izyaandev/HALFLIFE---PENDANTPCB/hardware/pcb/half-life-pendant-schematic.pdf

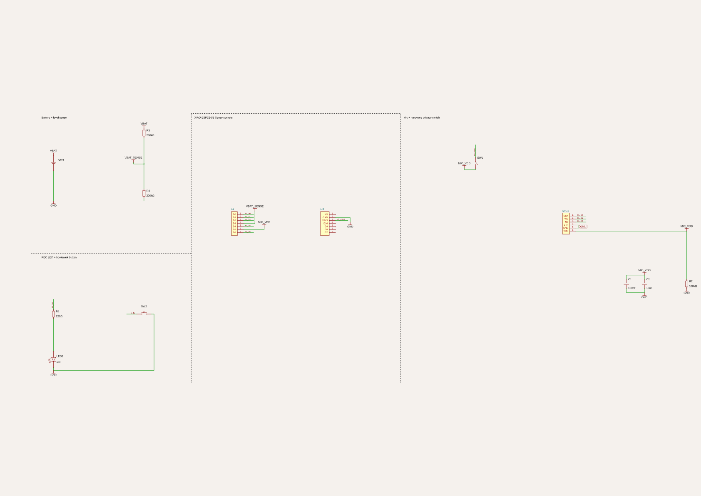
[picture p7: page 1]
