izyaandev/HALFLIFE---PENDANTPCB/hardware/bom.csv

Designator | Qty | Value | Description | PCB footprint | Placed on carrier PCB | Notes
U1 | 1 | XIAO ESP32-S3 Sense | Seeed Studio XIAO ESP32-S3 Sense with its camera/mic/microSD expansion board attached | plugs into HL and HR | Plug-in module | Brain of the pendant. Wi-Fi, Bluetooth, PSRAM and the microSD slot are all on this module.
HL, HR | 2 | 1x7 female header, 2.54 mm | Sockets the XIAO plugs into (15.24 mm between the two rows) | pinrow7_p2.54 female | Yes | Measure your XIAO row spacing before ordering boards.
U2 | 1 | INMP441 I2S MEMS microphone breakout | Digital microphone module, plugs into MIC1 | - | Plug-in module | L/R pin is tied to GND on the carrier, so it outputs the left channel.
MIC1 | 1 | 1x6 female header, 2.54 mm | Socket for the microphone module | pinrow6_p2.54 female | Yes
SW1 | 1 | Slide switch (SPST function, 2 pins used), 2.54 mm pin spacing | Hardware privacy switch in series with the mic power | pinrow2_p2.54mm | Yes | Pick a switch with a lever the printed slider cap can grab. Footprint is generic, check it against your part.
SW2 | 1 | SMD tactile button, about 6 x 6 mm | Bookmark button | smdpushbutton | Yes | Footprint is generic, check it against your part.
LED1 | 1 | Red LED, 0603 | Recording indicator | 0603 | Yes | Light reaches the lid through the printed light pipe.
R1 | 1 | 220 ohm, 0603 | LED current limiting resistor | 0603 | Yes
R2 | 1 | 100 kohm, 0603 | Pulldown so pin D5 reads LOW when the privacy switch is off | 0603 | Yes | Costs about 33 uA while the mic is powered.
R3, R4 | 2 | 200 kohm, 0603 | Battery voltage divider (read on D3) | 0603 | Yes | Divider constantly draws about 10 uA from the battery.
C1 | 1 | 100 nF, 0603 | Mic supply decoupling | 0603 | Yes
C2 | 1 | 10 uF, 0805 | Mic supply bulk capacitor | 0805 | Yes
BAT1 | 1 | JST PH 2-pin, 2.0 mm connector | Battery connector | jst2_p2mm_ph | Yes | The XIAO battery pads are on its underside, so a short wire links this connector to them.
B1 | 1 | LiPo 3.7 V, about 500 mAh, roughly 5 x 25 x 40 mm, with JST PH plug | Battery that sits under the carrier PCB | - | Off board | Check polarity: many LiPo cables are wired opposite to the JST PH pinout.
SD1 | 1 | microSD card | Local audio buffer, inserted in the XIAO Sense expansion board | - | Off board
CASE | 5 | 3D printed parts | case_base, case_lid, button_plunger, led_lightpipe, slider_cap | - | Off board | STL and STEP files in hardware/3d.
