izyaandev/HALFLIFE---PENDANTPCB/hardware/3d/half_life_pendant_assembly.step

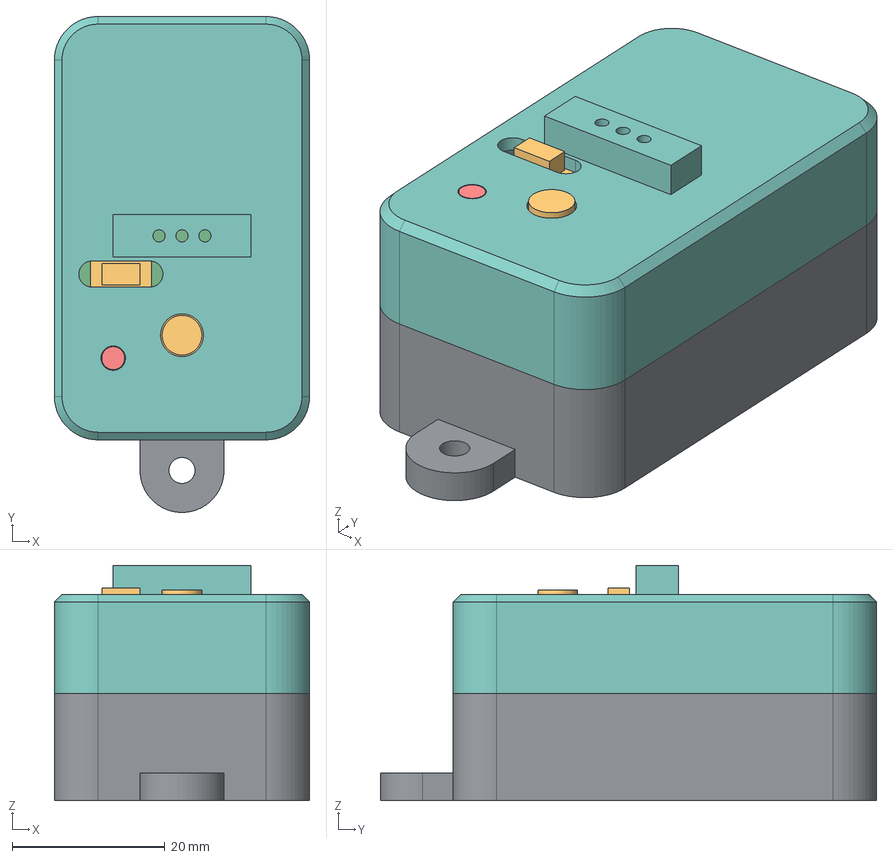
[picture p8: CAD file, 2026-10-25]
hardware/3d/half_life_pendant_assembly.step
33.4 x 64.9 x 30.8 mm
case_base
case_lid
button_plunger
led_lightpipe
slider_cap
ref_pcb
ref_header_L
ref_header_R
ref_xiao
ref_usbc
ref_battery
ref_mic_module
ref_mic_header
ref_switch
ref_button
ref_led
ref_jst
