izyaandev/HALFLIFE---PENDANTPCB/hardware/3d/step/button_plunger.step

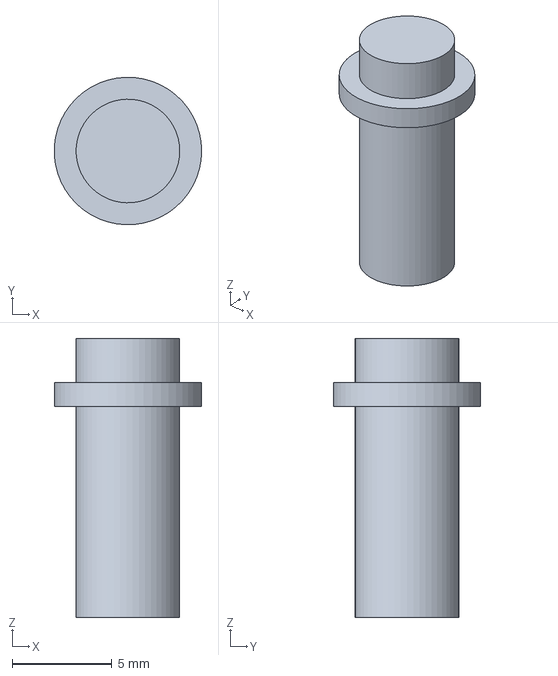
[picture p9: CAD file, 2026-10-25]
hardware/3d/step/button_plunger.step
7.39 x 7.40 x 14.0 mm
