izyaandev/HALFLIFE---PENDANTPCB/hardware/pcb/half-life-pendant-pcb-3d.step

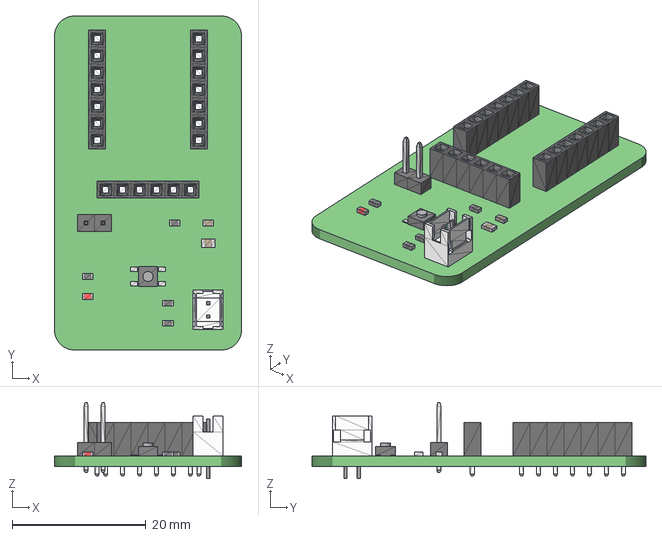
[picture p10: CAD file, 2026-10-25]
hardware/pcb/half-life-pendant-pcb-3d.step
28.0 x 50.0 x 11.4 mm
