izyaandev/HALFLIFE---PENDANTPCB/hardware/3d/step/led_lightpipe.step

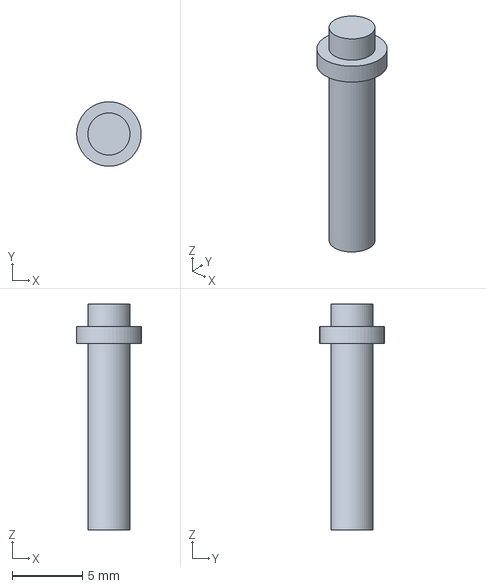
[picture p11: CAD file, 2026-10-25]
hardware/3d/step/led_lightpipe.step
4.60 x 4.60 x 16.1 mm
