izyaandev/HALFLIFE---PENDANTPCB/hardware/3d/step/case_base.step

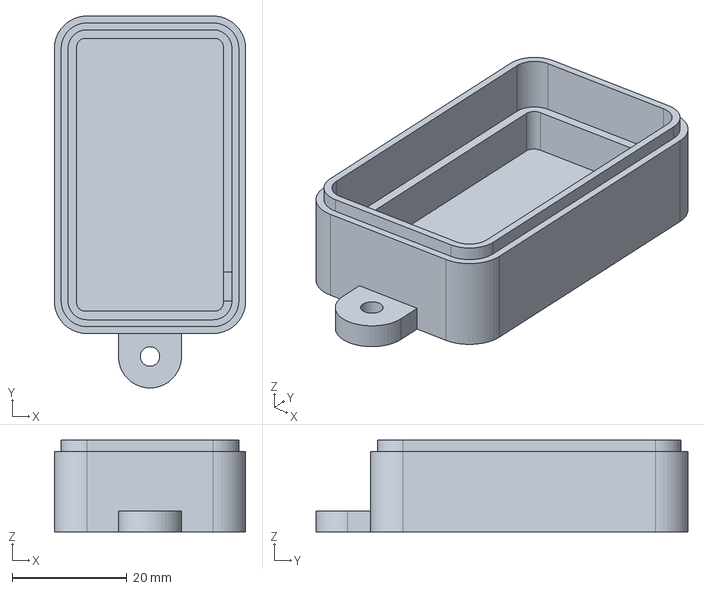
[picture p12: CAD file, 2026-10-25]
hardware/3d/step/case_base.step
33.4 x 64.9 x 16.0 mm
