izyaandev/HALFLIFE---PENDANTPCB/hardware/3d/step/case_lid.step

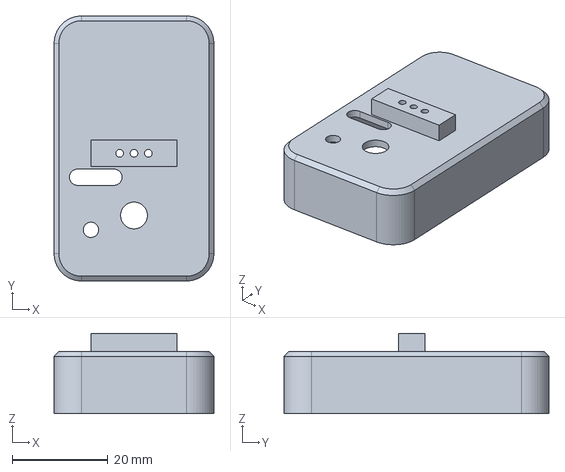
[picture p13: CAD file, 2026-10-25]
hardware/3d/step/case_lid.step
33.4 x 55.4 x 16.8 mm
