izyaandev/HALFLIFE---PENDANTPCB/hardware/3d/step/slider_cap.step

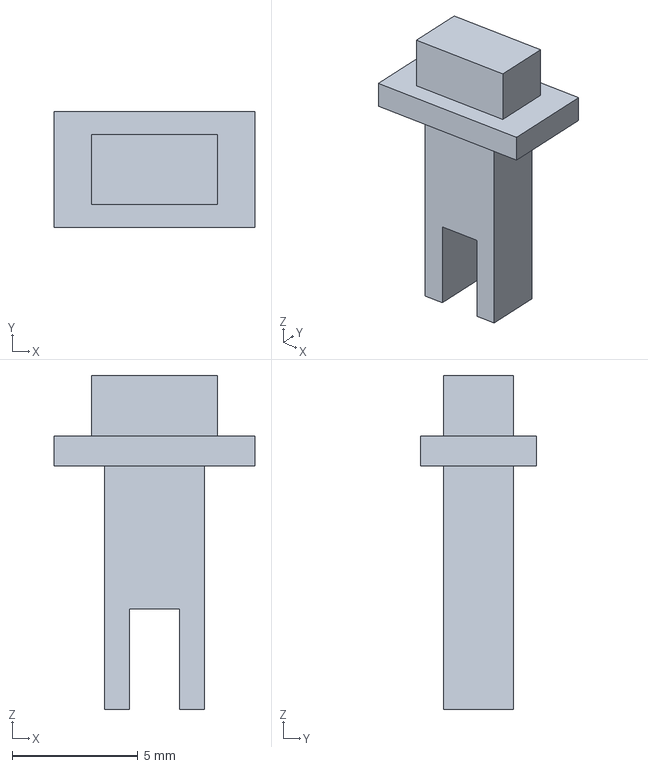
[picture p14: CAD file, 2026-10-25]
hardware/3d/step/slider_cap.step
8.00 x 4.60 x 13.3 mm
