izyaandev/HALFLIFE---PENDANTPCB/(list of files, cad)

Other CAD files:
hardware/3d/stl/button_plunger.stl
hardware/3d/stl/case_base.stl
hardware/3d/stl/case_lid.stl
hardware/3d/stl/led_lightpipe.stl
hardware/3d/stl/slider_cap.stl
