izyaandev/HALFLIFE---PENDANTPCB/hardware/pcb/half-life-pendant.kicad_pcb

## KiCad design hardware/pcb/half-life-pendant.kicad_pcb (2026-10-25)

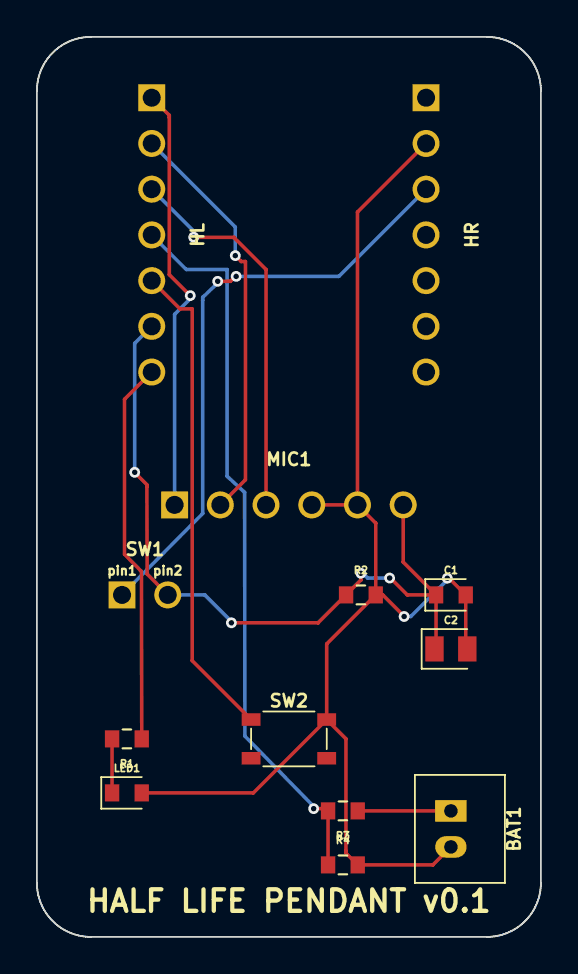
[picture p15: board half-life-pendant.kicad_pcb from above]

Board: 2 copper layers, 28.0 x 50.0 mm, 13 parts (0 on the bottom side), 11 nets.

Parts:
BAT1: BAT1; power_source_jst2_p2mm_ph
C1: 100nF; capacitor_cap0603
C2: 10uF; capacitor_cap0805
HL: HL; pin_header_pinrow7_p2_54_nopinlabels_female
HR: HR; pin_header_pinrow7_p2_54_nopinlabels_female
LED1: LED; led_0603_color_red
MIC1: MIC1; pin_header_pinrow6_p2_54_nopinlabels_female
R1: 220Ω; resistor_res0603
R2: 100kΩ; resistor_res0603
R3, R4: 200kΩ; resistor_res0603
SW1: SW; switch_pinrow2_p2_54mm
SW2: SW2; push_button_smdpushbutton

Connections:
GND: BAT1.2, C1.2, C2.2, HR.2, LED1.2, MIC1.4, MIC1.5, R2.2, R4.2, SW2.2
HL.D4 to SW2.pin1: HL.5, SW2.1
HL.D6 to R1.pin1: HL.7, R1.1
MIC1.SCK to HL.D0: HL.1, MIC1.1
MIC1.SD to HL.D2: HL.3, MIC1.3
MIC1.WS to HL.D1: HL.2, MIC1.2
MIC_VDD: C1.1, C2.1, HL.6, MIC1.6, R2.1, SW1.2
R1.pin2 to LED1.pos: LED1.1, R1.2
SW1.pin1 to HR.V3V3: HR.3, SW1.1
VBAT: BAT1.1, R3.1
VBAT_SENSE: HL.4, R3.2, R4.1
