izyaandev/HALFLIFE---PENDANTPCB/firmware/src/secrets.example.h

#pragma once
// copy this file to secrets.h and fill it in. secrets.h is in .gitignore.
#define WIFI_SSID  "your-wifi-name"
#define WIFI_PASS  "your-wifi-password"
#define API_URL    "https://your-server.example.com/api/upload"
#define API_TOKEN  "change-me"
#define DEVICE_ID  "pendant-01"
